LieBtrau/ultra-low-power-led-flasher/2026/Info/Inductor.md

# Inductor
The ESR isn't very important at these low currents.  The cheapest, shielded, ESR < 5 ohm,  1 mH inductors come in a 6x6 mm package.
LCSC C5339743, LCSC YNR6045-102M
