LieBtrau/ultra-low-power-led-flasher/2026/Info/LDO.md

# LDO
TPS7A02, with at least 1 µF output capacitance
