LieBtrau/ultra-low-power-led-flasher/2020/Info/MeasureLowPower/readme

Capacitance drop measurement is only reliable if the measured capacitance is much smaller than the input capacitance of the system.
