LieBtrau/ultra-low-power-led-flasher/2026/ulp-flasher/ulp-flasher.kicad_pcb

## KiCad design 2026/ulp-flasher/ulp-flasher.kicad_pcb (2026-09-13)

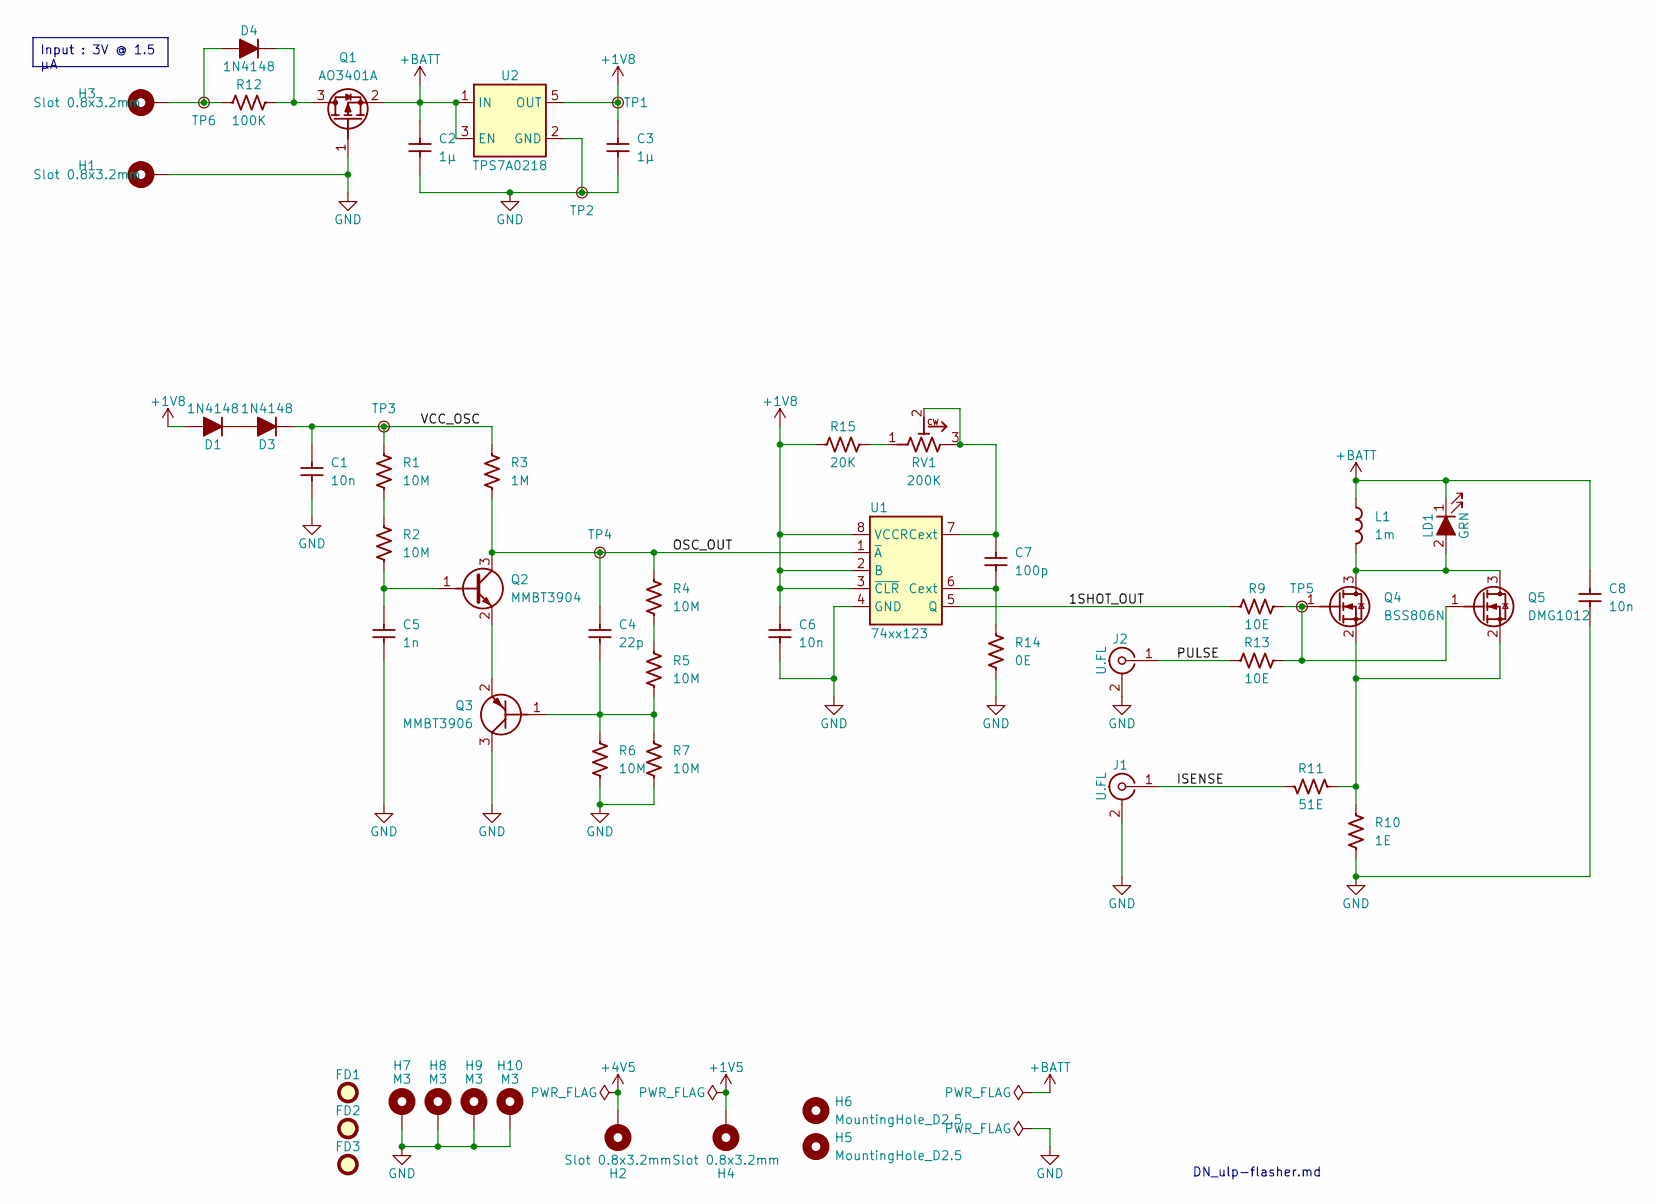
[picture p4: schematic ulp-flasher.kicad_sch, Ultra low power light]

Parts:
C1, C6, C8: 10n; C_0603_1608Metric; Voltage 50; Tolerance ±10%; MPN GCM188R71H103KA37D; LCSC C57112
C2, C3: 1µ; C_0603_1608Metric; Voltage 50; Tolerance ±10%; MPN CL10A105KB8NNNC; LCSC C15849
C4: 22p; C_0603_1608Metric; Voltage 50; Tolerance ±5%; MPN CL10C220JB8NNNC; LCSC C1653
C5: 1n; C_0603_1608Metric; Voltage 50; Tolerance ±10%; MPN CL10B102KB8NNNC; LCSC C1588
C7: 100p; C_0603_1608Metric; Voltage 50; Tolerance ±5%; MPN CL10C101JB8NNNC; LCSC C14858
D1, D3, D4: 1N4148; D_SOD-323; Voltage 100V; MPN 1N4148WS; LCSC C2128
FD1, FD2, FD3: Fiducial; Fiducial_1mm_Mask2mm
H1, H2, H3, H4: Slot 0.8x3.2mm; MountingHole_0.8x3.2mm
H5, H6: MountingHole_D2.5; MountingHole_2.5mm
H7, H8, H9, H10: M3; MountingHole_3.2mm_M3_Pad_Via
J1, J2: U.FL; U.FL_Hirose_U.FL-R-SMT-1_Vertical; MPN U.FL-R-SMT-1(10); LCSC C5137195
L1: 1m; L_Wurth_WE-LQS-6045; MPN 74404064102; LCSC C5339743
LD1: GRN; LED_PLCC_2835; MPN GT JTLPS1.13-KKLN-25-1-150-R33; LCSC C17637249
Q1: AO3401A; SOT-23-3; MPN AO3401A; LCSC C15127
Q2: MMBT3904; SOT-23-3; MPN MMBT3904-7-F; LCSC C20526
Q3: MMBT3906; SOT-23-3; MPN MMBT3906LT1G; LCSC C53444
Q4: BSS806N; SOT-23-3; MPN BSS806NH6327-HXY; LCSC C20606241
Q5: DMG1012; SOT-523; MPN DMG1012T-7; LCSC C7473321
R1, R2, R4, R5, R6, R7: 10M; R_0603_1608Metric; Tolerance 1%; MPN 0603WAF1005T5E; LCSC C7250
R3: 1M; R_0603_1608Metric; Tolerance 1%; MPN RC0603FR-071ML; LCSC C22935
R9, R13: 10E; R_0603_1608Metric; Tolerance 1%; MPN 0603WAF100JT5E; LCSC C22859
R10: 1E; R_0603_1608Metric; Tolerance 1%; MPN 0603WAF100KT5E; LCSC C22936
R11: 51E; R_0603_1608Metric; Tolerance 1%; MPN 0603WAF510JT5E; LCSC C23197
R12: 100K; R_0603_1608Metric; Tolerance 1%; MPN RC0603FR-07100KL; LCSC C25803
R14: 0E; R_0603_1608Metric; Tolerance 0; MPN RC0603FR-070RL; LCSC C21189
R15: 20K; R_0603_1608Metric; Tolerance 1%; MPN RC0603FR-0720KL; LCSC C4184
RV1: 200K; Potentiometer_Bourns_3314J_Vertical; Tolerance 20.00%; MPN 3314J-1-204E; LCSC C124643
TP1, TP2, TP3, TP4, TP5, TP6: TestPoint; TestPoint_Pad_D1.0mm
U1: 74xx123; TSSOP-8_3x3mm_P0.65mm; MPN 74LVC1G123DP,125; LCSC C513291
U2: TPS7A0218; SOT-23-5; MPN TPS7A0218PDBVR; LCSC C3748843

Connections:
+1V5: H4.1 (1_1)
+1V8: C3.2, C6.2, D1.2 (A), R15.2, TP1.1 (1_1), U1.2 (B), U1.3 (~CLR), U1.8 (VCC), U2.5 (OUT)
+4V5: H2.1 (1_1)
+BATT: C2.2, C8.2, L1.1, LD1.1 (C), Q1.2 (S), U2.1 (IN), U2.3 (EN)
/1SHOT_OUT: R9.1, U1.5 (Q)
/ISENSE: J1.1 (In), R11.2
/OSC_OUT: C4.2, Q2.3 (C), R3.1, R4.2, TP4.1 (1_1), U1.1 (~A)
/PULSE: J2.1 (In), R13.1
/VCC_OSC: C1.2, D3.1 (K), R1.2, R3.2, TP3.1 (1_1)
GND: C1.1, C2.1, C3.1, C5.1, C6.1, C8.1, H1.1 (1_1), H7.1 (1_1), H8.1 (1_1), H9.1 (1_1), H10.1 (1_1), J1.2 (Ext), J2.2 (Ext), Q1.1 (G), Q3.3 (C), R6.1, R7.1, R10.1, R14.1, TP2.1 (1_1), U1.4 (GND), U2.2 (GND)
unnamed: D1.1 (K), D3.2 (A)
unnamed: D4.2 (A), H3.1 (1_1), R12.1, TP6.1 (1_1)
unnamed: D4.1 (K), Q1.3 (D), R12.2
unnamed: L1.2, LD1.2 (A), Q4.3 (D), Q5.3 (D)
unnamed: C5.2, Q2.1 (B), R2.1
unnamed: Q2.2 (E), Q3.2 (E)
unnamed: C4.1, Q3.1 (B), R5.1, R6.2, R7.2
unnamed: Q4.1 (G), Q5.1 (G), R9.2, R13.2, TP5.1 (1_1)
unnamed: Q4.2 (S), Q5.2 (S), R10.2, R11.1
unnamed: R1.1, R2.2
unnamed: R4.1, R5.2
unnamed: R15.1, RV1.1
unnamed: C7.1, R14.2, U1.6 (Cext)
unnamed: C7.2, RV1.2, RV1.3, U1.7 (RCext)

Notes on the sheet:
DN_ulp-flasher.md
Input : 3V @ 1.5 µA

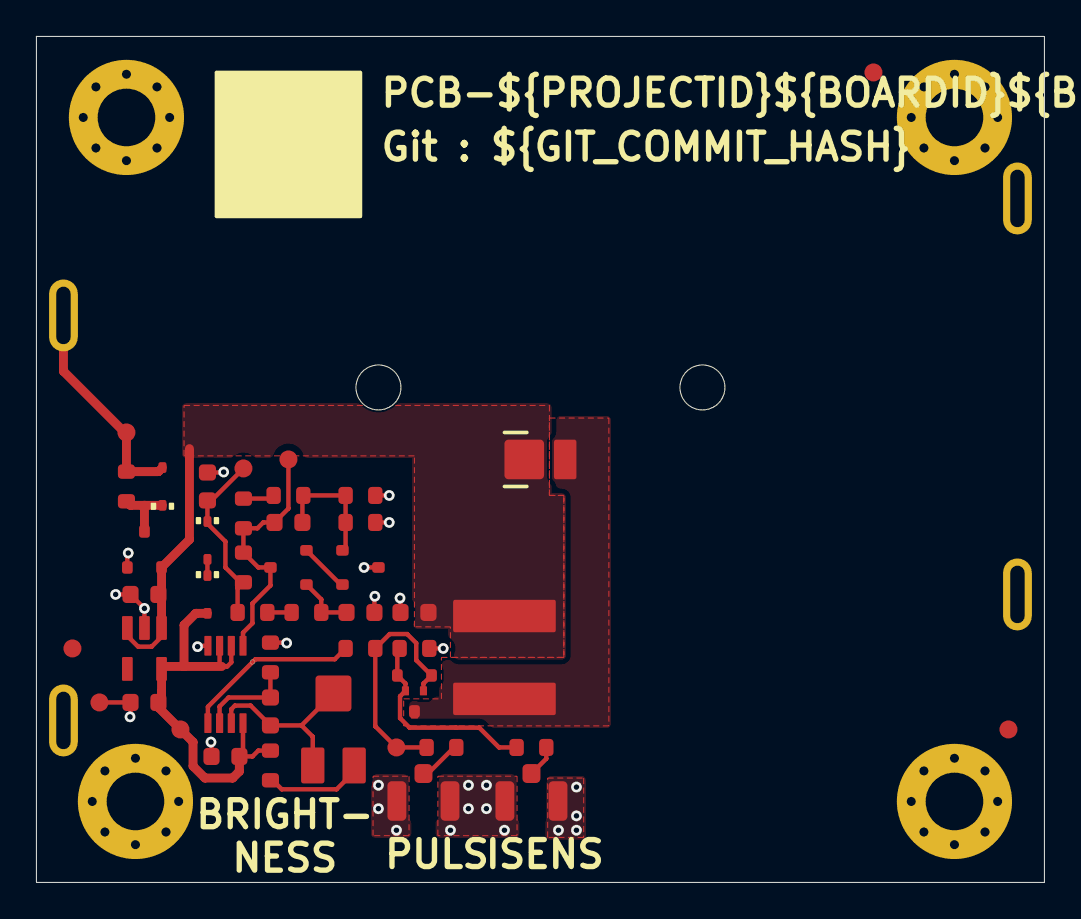
[picture p5: board ulp-flasher.kicad_pcb from above]

Board: 2 copper layers, 56.0 x 47.0 mm, 56 parts (0 on the bottom side), 22 nets.
