LieBtrau/ultra-low-power-led-flasher/2020/Info/protrinket3v_bootloader/protrinket3v_bootloader.ino

// Standalone AVR ISP programmer
// August 2011 by Limor Fried / Ladyada / Adafruit
// Jan 2011 by Bill Westfield ("WestfW")
//
// this sketch allows an Arduino to program a flash program
// into any AVR if you can fit the HEX file into program memory
// No computer is necessary. Two LEDs for status notification
// Press button to program a new chip. Piezo beeper for error/success 
// This is ideal for very fast mass-programming of chips!
//
// It is based on AVRISP
//
// using the following pins:
// 10: slave reset
// 11: MOSI
// 12: MISO
// 13: SCK
//  9: 8 MHz clock output - connect this to the XTAL1 pin of the AVR
//     if you want to program a chip that requires a crystal without
//     soldering a crystal in
// ----------------------------------------------------------------------


#include "optiLoader.h"
#include "SPI.h"

// Global Variables
int pmode=0;
byte pageBuffer[128];		       /* One page of flash */


/*
 * Pins to target
 */
#define SCK 13
#define MISO 12
#define MOSI 11
#define RESET 10


void setup () {
  Serial.begin(57600);			/* Initialize serial for status msgs */
  Serial.println(F("\nAdafruit Trinket 3V programmer - June 9 2015"));

  pinMode(LED_PROGMODE, OUTPUT);
  pulse(LED_PROGMODE,2);
  pinMode(LED_ERR, OUTPUT);
  pulse(LED_ERR, 2);
}

void loop (void) {
  Serial.println("\nType 'G' for next chip");
  while (1) {
    if  (Serial.read() == 'G')
      break;  
  }
    
  target_poweron();			/* Turn on target power */

  uint16_t signature;
  image_t *targetimage;
        
  if (! (signature = readSignature()))		// Figure out what kind of CPU
    error("Signature fail");
  if (! (targetimage = findImage(signature)))	// look for an image
    error("Image fail");
  
  eraseChip();

  if (! programFuses(targetimage->image_progfuses))	// get fuses ready to program
    error("Programming Fuses fail");
  
  if (! verifyFuses(targetimage->image_progfuses, targetimage->fusemask) ) {
    error("Failed to verify fuses");
  } 

  end_pmode();
  start_pmode();

  byte *hextext = targetimage->image_hexcode;  
  uint16_t pageaddr = 0;
  uint8_t pagesize = pgm_read_byte(&targetimage->image_pagesize);
  uint16_t chipsize = pgm_read_word(&targetimage->chipsize);
        
  //Serial.println(chipsize, DEC);
  while (pageaddr < chipsize) {
     byte *hextextpos = readImagePage (hextext, pageaddr, pagesize, pageBuffer);
          
     boolean blankpage = true;
     for (uint8_t i=0; i<pagesize; i++) {
       if (pageBuffer[i] != 0xFF) blankpage = false;
     }          
     if (! blankpage) {
       if (! flashPage(pageBuffer, pageaddr, pagesize))	
	 error("Flash programming failed");
     }
     hextext = hextextpos;
     pageaddr += pagesize;
  }
  
  // Set fuses to 'final' state
  if (! programFuses(targetimage->image_normfuses))
    error("Programming Fuses fail");
    
  end_pmode();
  start_pmode();
  
  Serial.println("\nVerifing flash...");
  if (! verifyImage(targetimage->image_hexcode) ) {
    error("Failed to verify chip");
  } else {
    Serial.println("\tFlash verified correctly!");
  }

  if (! verifyFuses(targetimage->image_normfuses, targetimage->fusemask) ) {
    error("Failed to verify fuses");
  } else {
    Serial.println("Fuses verified correctly!");
  }
  target_poweroff();			/* turn power off */
}



void error(char *string) { 
  Serial.println(string); 
  digitalWrite(LED_ERR, HIGH);  
  while(1) {
    delay(10);
  }
}

void start_pmode () {
  pinMode(13, INPUT); // restore to default

  SPI.begin();
  SPI.setClockDivider(SPI_CLOCK_DIV128); 
  
  debug("...spi_init done");
  // following delays may not work on all targets...
  pinMode(RESET, OUTPUT);
  digitalWrite(RESET, HIGH);
  pinMode(SCK, OUTPUT);
  digitalWrite(SCK, LOW);
  delay(50);
  digitalWrite(RESET, LOW);
  delay(50);
  pinMode(MISO, INPUT);
  pinMode(MOSI, OUTPUT);
  debug("...spi_transaction");
  spi_transaction(0xAC, 0x53, 0x00, 0x00);
  debug("...Done");
  pmode = 1;
}

void end_pmode () {
  SPCR = 0;				/* reset SPI */
  digitalWrite(MISO, 0);		/* Make sure pullups are off too */
  pinMode(MISO, INPUT);
  digitalWrite(MOSI, 0);
  pinMode(MOSI, INPUT);
  digitalWrite(SCK, 0);
  pinMode(SCK, INPUT);
  digitalWrite(RESET, 0);
  pinMode(RESET, INPUT);
  SPI.end();      //  need to call SPI.end() before another call to SPI.begin()  pmode = 0;
}


/*
 * target_poweron
 * begin programming
 */
boolean target_poweron ()
{
  pinMode(LED_PROGMODE, OUTPUT);
  digitalWrite(LED_PROGMODE, HIGH);
  digitalWrite(RESET, LOW);  // reset it right away.
  pinMode(RESET, OUTPUT);
  delay(100);
  Serial.print("Starting Program Mode");
  start_pmode();
  Serial.println(" [OK]");
  return true;
}

boolean target_poweroff ()
{
  end_pmode();
  digitalWrite(LED_PROGMODE, LOW);
  return true;
}
