LieBtrau/ultra-low-power-led-flasher/2020/Info/protrinket3v_bootloader/images.cpp

#include "optiLoader.h"

const image_t PROGMEM image_328 = {
    {"trinket_3V_2015_03_17.hex"},
    {"atmega328"},
    0x950F,				/* Signature bytes for 328P */
    {0x3F, 0xFF, 0xD0, 0x05},           // pre program fuses (prot/lock, low, high, ext)
    {0x0F, 0x00, 0x00, 0x00},           // post program fuses
    {0x3F, 0xFF, 0xFF, 0x07},           // fuse mask
    31866,     // size of chip flash in bytes
    128,   // size in bytes of flash page
    {
":2070000058C000008BC000006FC000006DC000006BC0000069C0000067C0000065C0000011\n"
":2070200063C0000061C000005FC000005DC000005BC0000059C0000057C0000055C0000070\n"
":2070400053C0000051C000004FC000004DC000004BC0000049C0000047C0000045C00000D0\n"
":2070600043C0000041C00000040309041203410064006100660072007500690074001003A0\n"
":20708000550053004200740069006E00790012011001FF00000881179F0C050101020001CA\n"
":2070A00009021200010100803209040000000000000011241FBECFEFD8E0DEBFCDBF11E050\n"
":2070C000A0E0B1E0E8E7FCE702C005900D92A230B107D9F712E0A2E0B1E001C01D92A33451\n"
":2070E000B107E1F796D3C6C58BCFA82FB92F80E090E041E050EA609530E009C02D91822793\n"
":207100009795879510F084279527305EC8F36F5FA8F30895EADF8D939D930895CF93CFB7D3\n"
":20712000CF93C3954F9BE9F74F9B09C04F9B07C04F9B05C04F9B03C04F9B01C0A1C0DF938D\n"
":20714000C0912602DD27C35DDD4F4F9B02C0DF91EBCF2F930F931F9309B12FEF07FB20F987\n"
":207160004F933F9319B14FEF012707FB21F93BE031C04E7F012F19B1216028C0102F4D7FC8\n"
":207180002260000009B129C04B7F2460012F000019B12BC019B1477F28602AC04F7E09B10E\n"
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
":1A7C600092BD81BD20BD0FB6F894FA9AF99A0FBE01960895F894FFCF5AFF74\n"
":00000001FF\n"
    }
};

/*
 * Table of defined images
 */
const image_t *images[] = {
  &image_328,
};

uint8_t NUMIMAGES = sizeof(images)/sizeof(images[0]);
