LieBtrau/ultra-low-power-led-flasher/(commit log)

2020-04-25 RTC generates 64Hz clock output
2020-06-18 Migrating to Adafruit ProTrinket 3V
2021-08-15 Adding license statement + pin connections
